danielrfry/opl2sd1/(threads)

Thread 1 (2022-04-13):

Publishing work on MIDI implementation?

nikitalita, 2022-04-13:
Hi,

there’s a thread on VOGONS where they discuss trying to implement MIDI on the MA-3 (aka the predecessor to the SD-1) and they mention they would love to see the SD-1 MIDI implementation published: https://www.vogons.org/viewtopic.php?p=1057380#p1057380

is this in the cards in the near future?

danielrfry, 2022-04-13:
Yes, I’m very keen to release the code as soon as it is in a generally usable state. The project includes several components (the names are placeholders):

- `libfmcore`: device-independent MIDI implementation in C++, with drivers for OPL2, OPL3, OPM and SD-1. Can be built as an RP2040 or Teensyduino library (possibly other Arduino targets too) for embedding, or linked into `libfm` for use on desktop/web platforms.
- `libfm`: library incorporating `libfmcore`, the DOSBox OPL emulator, and the MAME OPM emulator, targeting Linux, macOS and web (as a WASM module). Allows use of the MIDI implementation without dedicated hardware.
- `opl-patch-editor`: particularly badly named GUI patch editor and software synthesiser for OPL, OPM and SD-1. Implemented as a web app using React, `libfm`, web audio and web MIDI.
- `vgmtools`: collection of tools implemented in Python for converting, ‘disassembling’ and editing VGM/DRO files, converting MIDI to VGM, playing or rendering VGM/MID files to WAV, etc. using `libfm`.

Before releasing this, I’d like to:
- Rename everything. The placeholder names I picked are misleading and conflict with existing projects.
- Figure out licensing - either find a licence that is compatible with both the DOSBox/MAME emulator code in `libfm`, replace the emulators with equivalents with compatible licences, or extract the code into a separate project with a different licence.
- Implement MIDI device selection in the patch editor. Currently the MIDI input/output devices are automatically selected, with no easy way to override the selection if it is incorrect.
- Implement exporting patches as SYX files to make using custom patches in sequencers easier.

I hope to find the spare time to complete these last few pieces of work soon.

danielrfry, 2022-05-02:
An update for anyone interested: MIDI device selection is now implemented. I expect this to be the largest of these pieces of work.

I haven't made a final decision regarding licensing yet, but I expect to release `libfmcore` under the MIT Licence, and everything else under GPL v2. This is due to the use of the MAME YM2151 emulator, which uses this licence, in `libfm`. An alternative might be to replace it with the Nuked-OPM emulator, which is LGPL-licensed.

OPLx, 2022-05-06:
You may also want to take a look at [ymfm](https://github.com/aaronsgiles/ymfm) as well.

danielrfry, 2022-05-06:
@OPLx Ah, perfect - thanks for the tip! I've concluded that licensing for `libfm` doesn't matter too much, as it is essentially just glue code between the MIDI implementation and the emulators. But more of a concern is that using GPL'd code from Python or JS seems to count as 'linking' under the terms of that licence, which would affect `vgmtools` and the patch editor. So this sounds like an ideal solution to keep things flexible for those.

OPLx, 2022-05-07:
@danielrfry No problem.  Please keep up the great work!

danielrfry, 2022-05-10:
I've now replaced the DOSBox OPL and MAME OPM emulators with their equivalents from ymfm. Conveniently, this now means that all the code in libfm from other projects is BSD 3-clause-licensed.

libfm and vgmtools do not contain any code from other projects.

The patch editor, being an npm-based web app, has many dependencies - however, all use permissive licences that allow redistribution in source or compiled form. Certainly there is no (L)GPL'd code. So I think for simplicity, I will use BSD 3-clause for this too.

TLDR: Everything will be released under the BSD 3-clause licence.

danielrfry, 2022-05-17:
.SYX export is now implemented - so the largest remaining task is to rename all the projects. In addition, I have a few small issues to fix, and I'll try to write up some basic documentation as a starting point, then I should hopefully be ready to make the repositories public.

danielrfry, 2022-06-03:
As is often the way, the final small tasks multiplied... but I've now got to a point where I'm comfortable releasing everything, so the repositories are now public. I have named the project "Note Salad", in a move I may later regret.

https://github.com/danielrfry/notesalad/
https://github.com/danielrfry/notesalad-tools/
https://github.com/danielrfry/notesalad-editor/

I hope it can be of some use to someone!

Closed 2022-06-03.

Thread 2 (2023-03-25):

Stereo OPL2/OPL3 playback using two SD-1 modules

denjhang, 2023-03-25:
I've found that many OPL3 tracks have stereo, whereas the SD-1 is mono. So use two SD-1 combinations to achieve stereo.

danielrfry, 2023-04-06:
A few people have asked about this so I'm going to try.

One potential issue is that the YMF825Board has the clock oscillator integrated. My suspicion was that the two chips running with independent clocks may produce audio signals that are out-of-phase and create unintentional stereo separation where there should be none.

As a first test, I've connected both YMF825s to the same SPI bus, sharing the same CS and RST lines, so that in theory they receive the same signals simultaneously. I recorded a sample of music playback and subtracted one channel from another in Audacity, which should result in silence if the two chips are producing the same output; however, the tracks do indeed differ in phase and some higher frequencies are still audible in the combined channels. (Those sounds are also audibly separated when listening to the unmodified output).

It's possible that running the two chips from the same clock source would solve that, however I don't have the equipment or skills necessary to remove the YMF825 from the board, nor do I have a source of bare YMF825 chips to build into a new circuit.

It's an interesting experiment nonetheless so I will try updating the code to produce stereo output, and maybe someone with the capability and resources to build a dual-YMF825 circuit can make use of it.

denjhang, 2023-04-17:
I am capable of building dual YMF825 modules, I will draw the schematic, PCB and solder, I also have some YMF825 chips enough for testing. I can assist you with hardware testing.

denjhang, 2023-04-17:
In-phase clocks don't seem to solve this problem. Because it is rumored that the initial phase of Yamaha FM is random.

denjhang, 2023-04-17:
If you can provide interesting OPL3 VGM files like EndlessBreak, I'd like to hear that too.

danielrfry, 2023-04-18:
Yes, it's still an interesting experiment even if it's not possible to synchronise the two YMF825s perfectly.

I've pushed the stereo code, the builds are here: https://github.com/danielrfry/opl2sd1/actions/runs/4736826783
There are now two firmware images, one for mono and one for stereo operation.

If you'd like to try it, connect both YMF825 modules to the same SPI bus, with pin 6 → left channel YMF825 CS, pin 7 → right channel YMF825 CS.

(Please note I've changed the default pin assignments, so pin 6 is now used instead of pin 1 for CS in the mono firmware too. This is so that I can use pins 0 and 1 for debugging via UART. The documentation is not yet updated).

Endless Break by Pigu is on [Battle of the Bits](https://battleofthebits.org/arena/Entry/Endless+Break+%28short+ver.%29/30542/)!

danielrfry, 2023-04-19:
I think there may still be bugs in the channel allocator, so it might be possible to improve the performance further on 1 or 2 chips. I'd like to work some more on that when I have more time (I just needed a break from it for a little while!)

But if you'd like to build the 4 chip device anyway, I'd certainly like to see it and will be happy to update the code to support that. We can continue the discussion of that over on issue #7. Thanks!

Closed 2023-04-20.

Thread 5 (2023-04-08):

OPL drums are not audible.

denjhang, 2023-04-08:
When I listen to tracks like the YS II Special, the OPL2's own drums are barely audible.

danielrfry, 2023-04-08:
The OPL drum mode is not currently implemented as the SD-1 does not have an equivalent function. I was not aware of any soundtracks that used it - thank you for highlighting this one.

denjhang, 2023-04-08:
[Ys_II_Special_(IBM_PC_AT).zip](https://github.com/danielrfry/opl2sd1/files/11183453/Ys_II_Special_.IBM_PC_AT.zip)

denjhang, 2023-04-08:
I hope you can make similar drum sounds to replace the drum sounds that come with the OPL3. I can provide the relevant OPL3 parameters.

danielrfry, 2023-04-08:
> I can provide the relevant OPL3 parameters.
That would be very helpful, thank you.

denjhang, 2023-04-17:
`OPLL Instrument in OPL Format
-----------------------------
OPL Register Order
20 23 40 43 60 63 80 83 E0 E3 C0

Melody Instruments:
49 4C 4C 00 00 00 00 00 01 00 04	0 - User
61 61 1E 00 F0 78 00 17 01 00 0E	1 - Violin
13 41 1E 00 D7 F7 13 13 00 01 0A	2 - Guitar
13 01 99 00 F2 F4 11 23 00 00 08	3 - Piano
21 61 1B 00 AF 64 40 27 00 00 0E	4 - Flute
22 21 1E 00 F0 75 08 18 00 00 0C	5 - Clarinet
31 22 16 00 90 71 00 13 00 00 0A	6 - Oboe
21 61 1D 00 82 80 10 17 00 00 0E	7 - Trumpet
23 21 2D 00 C0 70 07 07 01 00 0C	8 - Organ
61 61 1B 00 64 65 10 17 00 00 0C	9 - Horn
61 61 0C 00 85 F0 70 07 01 01 00	A - Synthesizer
23 01 07 00 F0 A4 00 22 01 00 02	B - Harpsichord
97 C1 24 00 FF F8 22 12 00 00 0E	C - Vibraphone
61 10 0C 00 F2 F4 40 44 00 00 0A	D - Synth Bass
01 01 55 00 F3 92 F3 F3 00 00 06	E - Acoustic Bass
61 41 89 00 F1 F4 F0 13 00 00 06	F - Electric Bass

Drums:
01 01 16 00 FD F8 2F 6D 00 00 00	BD
01 01 00 00 D8 D8 F9 F8 00 00 00	HH / SD
05 01 00 00 F8 BA 49 55 00 00 00	TOM / TOP CYM`

denjhang, 2023-04-17:
I find it hard to get the HH/SD and TOM/TOP CYM sounds using conventional methods, because the four OPL drum sounds only use 1OP, and their waveforms are not necessarily sine waves.
Only BD can be obtained by conventional methods, the parameters are given:
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

denjhang, 2023-04-17:
https://www.smspower.org/maxim/Documents/YM2413ApplicationManual#v4
(V-4) Procedure of Percussion Sound Synthesis
Channels 7, 8 and 9 are used to synthesize percussion sounds. Five kinds of percussion sounds are generated by using these three channels and six slots. For the bass drum (BD), two slots are used to synthesize FM sounds. Therefore, bass drum sounds can be produced basically by the same procedure from (a) to (c). The other four kinds of percussion sounds (high hat, top cymbal, tom-tom, and snare drum) are described as follows.

OPLL includes a noise oscillator obtained by composing a white noise generator with several frequencies. This noise oscillator is specified by the frequency information (BLOCK, F-Number, Multiple) of the 8 and 9 channels. When composed with white noise, phase output suitable for percussion instruments is generated and given to the operator. Thus phases of four instruments are generated from two sets of frequency information. It is known empirically that the optimum ratio of two frequencies is 3:1 (f7CH = 3×f8CH). Now phase data of individual instruments are obtained. Next, we multiply this output with envelope information. Since the envelope is set as 1 slot -> 1 percussion instrument, values that reflect the characteristics of individual percussion instruments, as with melody instruments, are set in ROM. (Refer to [III-1-7](https://www.smspower.org/maxim/Documents/YM2413ApplicationManual#iii17))

denjhang, 2023-04-17:
So the built-in drum sound uses OPL's built-in noise generator, but the YMF825 doesn't have such a thing at all.

denjhang, 2023-04-17:
I'll come up with an approximation through lots of experimentation. Here is the Snare drum replacement:
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

denjhang, 2023-04-17:
BD seems to be a bit unsatisfactory, so I will try some more.

denjhang, 2023-04-18:
Here's the new BD, sounds okay
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

denjhang, 2023-04-20:
The latest experimental OPL drum sound, closer to the original sound.
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

denjhang, 2023-04-20:
[OPL Drum3.zip](https://github.com/danielrfry/opl2sd1/files/11279490/OPL.Drum3.zip)
I uploaded the wopl, you can experiment and quote as you like.

denjhang, 2023-04-20:
Many friends are interested in this function, I suggest you try to update the OPL drum. Once this feature is perfected, all OPL2 tracks will play perfectly. (However, when OPL3 uses its own drum channel, the total number of channels will be 15+5=20)

Thread 6 (2023-04-08):

Playing VGM with OPL3 dynamic channel allocation is very stuck

denjhang, 2023-04-08:
This is very strange.

denjhang, 2023-04-08:
[Invention and Sinfonia.zip](https://github.com/danielrfry/opl2sd1/files/11183010/Invention.and.Sinfonia.zip)

danielrfry, 2023-04-08:
Yes, the channel allocator is very simplistic currently; I implemented just enough for tracker tunes and OPL2 soundtracks that use the same set of channels repeatedly - it does not work well for MIDI for example, if many OPL channels are used in sequence. I hope to improve this soon.

danielrfry, 2023-04-10:
Audio files demonstrating the issue, for comparison:
[OPL2SD1_Issue_6.zip](https://github.com/danielrfry/opl2sd1/files/11190021/OPL2SD1_Issue_6.zip)

OPL3 version rendered using ymfm via `nsplay` from [Note Salad Tools](https://github.com/danielrfry/notesalad-tools)
YMF825 version played back using opl2sd1 firmware and RetroWave_Player on macOS

denjhang, 2023-04-10:
The problem seems to be solved, so how do I play my VGM?

danielrfry, 2023-04-10:
I haven't made any changes to the channel allocator yet. There are notes being cut off in the YMF825 version I posted above - were you experiencing a different issue?

I did not test the Python VGM player on Windows as I don't often use that OS, so there may be some platform-specific issues as well.

The latest opl2sd1 revision implements the RetroWave OPL3 serial protocol, so you could try the latest firmware version and the [RetroWave_Player](https://github.com/SudoMaker/RetroWave) tool to play VGM files.

denjhang, 2023-04-10:
It looks like I have to recompile the firmware.
It seems that using the Pico SDK on Windows 10 is a bit complicated, can you just upload the latest UF2 firmware so I can test it quickly?

danielrfry, 2023-04-10:
I've added automated builds with GitHub Actions, you can find the UF2 for the current revision here:

https://github.com/danielrfry/opl2sd1/actions/runs/4657279593

denjhang, 2023-04-10:
I have updated the firmware, but how to use nsplay? I found that when I use Retro Wave Player directly, the notes are still cut off.
And the compatibility of Retro Wave Player to VGM is poor, when encountering non-OPL3 music, Retro Wave Player will not skip automatically and the program will close automatically. When playing Invention.and.Sinfonia.zip, only 5 tracks can be played continuously, and then the program will close automatically.
So I suggest you keep the Python player you wrote for stronger compatibility.

danielrfry, 2023-04-10:
The audio files were just to demonstrate the correct/incorrect sound, to help with identifying/fixing the issue - I haven't made any changes to the allocator code yet.

The OPL3 version is rendered using `nsplay` and the `ymfm` emulator, and demonstrates the correct sound.
The YMF825 version is recorded output from the current firmware, which has the channel allocation issues.

My aim is to add RetroWave protocol support to `nsplay` (which has more features than the sample Python VGM player in this repository) so that it can be used with this device, the RetroWave OPL3 board, and the `ymfm` emulator. That way there will be no need to maintain two separate player programs, and any VGM player compatible with RetroWave can also be used.

danielrfry, 2023-04-10:
I have re-written the channel allocator which I believe will resolve some of the issues described here and in #13.

Please try the latest firmware build from here:
https://github.com/danielrfry/opl2sd1/actions/runs/4659405073

denjhang, 2023-04-11:
Although the latest firmware has alleviated the problem of note stuttering, it is not perfect, and many sustains and chords will still be "swallowed".

denjhang, 2023-04-11:
You can test my music and sound bank with the latest version of OPL3BankEditor
[Coup De Coeur.zip](https://github.com/danielrfry/opl2sd1/files/11195738/Coup.De.Coeur.zip)

denjhang, 2023-04-11:
Regarding the channel allocation algorithm, I suggest that you can also refer to the method of OPL3BankEditor, because I run this program directly on the computer and it will play my music perfectly.

denjhang, 2023-04-11:
It is obvious that YMF825 lacks more than 2 channels than OPL3. When the channels are obviously insufficient, my suggestion is to give higher priority to the shorter notes, let them cover the longer notes, and let the notes that appear later cover the earliest notes. The notes that appear.

denjhang, 2023-04-11:
Because in many piano MIDIs, there are many overlong sustained tones, which are usually caused by the sustain pedal or reverberation. Once it lasts for 1S, this note will have no meaning, so these notes can be covered.

danielrfry, 2023-04-12:
I have fixed some bugs that were causing notes to be cut off when they should not have been, if you'd like to try the latest build:

https://github.com/danielrfry/opl2sd1/actions/runs/4683260124

I'm hopeful this version will handle sustained notes much better.

denjhang, 2023-04-13:
Today I tried the piano solo midi music without sustain, and found that it is normal when using 2op tones, but when I use 2x2op tones, the sound swallowing phenomenon still occurs.
For midi piano solos that use a lot of extended sounds, the current version of the firmware still swallows the sound seriously.
[Yiruma-SOLO.zip](https://github.com/danielrfry/opl2sd1/files/11224313/Yiruma-SOLO.zip)
Here's a set of solo midi pianos that make heavy use of the sustain pedal.

danielrfry, 2023-04-15:
I think there might be more than one issue here - I've fixed a couple more things but I'm not sure whether they are related to the problem you've described. I have found it quite difficult to debug with such complex MIDI files.

https://github.com/danielrfry/opl2sd1/actions/runs/4708450511/jobs/8350896014

Please could you find a single, simple example of the problem, and provide detailed steps to recreate it (including the exact bank file and instrument to use in OPL3BankEditor). If you could provide short recordings showing an example of the correct/incorrect playback as well, that would help me to understand the issue better. Thanks!

denjhang, 2023-04-15:
The latest version of the firmware has improved significantly. Sincerely happy for you.

denjhang, 2023-04-15:
https://user-images.githubusercontent.com/61811583/232237607-3710a828-a588-47ff-adfb-d3d51a026478.mp4
https://user-images.githubusercontent.com/61811583/232237615-5de20298-be54-4d92-803c-75f51be8126d.mp4
These two videos show the correct sound, too beautiful piano music (at least I think so). By the way, this is my completely original OPL3 piano sound, only using FM parameters to realize the reverb effect, without relying on any external DSP reverb.
Below are the midi files and library files played in the video. I use "Warm Grand Piano", Bank 0, ID 7.
[Lost In Island.zip](https://github.com/danielrfry/opl2sd1/files/11239995/Lost.In.Island.zip)

denjhang, 2023-04-16:
I've found that it probably takes more than 2 SD-1 modules to play the music perfectly. At present, it does not seem to be a problem with the scheduling algorithm, and it is very likely that there are still insufficient channels when it is optimized to the extreme.

denjhang, 2023-04-16:
Most solo midi piano music that doesn't make extensive use of the sustain pedal can now be played normally.

denjhang, 2023-04-16:
On the other hand, even when I play Lost In Island.zip with 2op patches, there are still a lot of notes being cut off and swallowed.

Thread 7 (2023-04-08):

Support 4 or more SD-1 modules to play full OPL3 stereo or dual-chip music.

denjhang, 2023-04-08:
Because Pico has enough IO ports, you can consider it.

denjhang, 2023-04-19:
I'm going to make a new version of the schematic diagram and PCB, and I plan to do advanced design. I feel that to play all OPL3 tracks perfectly, four chips are needed, because some tracks use all 18 channels at the same time, and the channels are still not enough. No matter how you schedule it . So I'm going to add 4 SD-1 module designs that don't currently exist. I hope you can make pin 8, 9 (or even more) as chip select for the third and fourth YMF825.
In other words, the current chip selection situation is as follows:
pin6->CS_L
pin7->CS_R
pin8->CS_L2
pin9->CS_R2

danielrfry, 2023-04-20:
Amazing! I will get to work on the 4-chip code ASAP 😄

danielrfry, 2023-04-20:
I've been using the UART on pins 0 and 1 for real-time logging, so it might be useful if that could be brought out somewhere 👍

danielrfry, 2023-04-22:
The latest build here can drive four YMF825 chips:
https://github.com/danielrfry/opl2sd1/actions/runs/4774752669

(It's the dual-stereo firmware version).

I only have two YMF825 boards, so I haven't been able to test this fully - but I have been able to connect two at a time, make two recordings and mix them and it sounds OK.

denjhang, 2023-04-26:
I've done my 4xYMF825 hardware, but I'm finding that the stereo effect is not noticeable.I wanted the stereo effect to be stronger, which meant that the music played by the two chips needed to be distinctly different.
On the other hand, I found that the OPL drum sound is still not audible, I think you should fix it.

danielrfry, 2023-04-26:
The stereo effect should be the same as that of the OPL3, and I've found that to be true in my testing. Were you expecting it to add stereo separation to mono sounds? (It does this a little, but not intentionally, due to the phase differences we've discussed elsewhere!)

I've started work on implementing the OPL drum mode - just a reminder though, I work on this in my limited spare time, so things may sometimes progress slowly.

denjhang, 2023-04-27:
What I really mean is that currently the OPL2SD1 uses 4 YMF825 modules to play stereo OPL3 VGM, the stereo effect is not obvious, not stereo is required to play mono tracks.
Such as Moondriver Demo
[MoonDriver Demo.zip](https://github.com/danielrfry/opl2sd1/files/11343076/MoonDriver.Demo.zip)

By the way, in the current situation, it is also possible to play mono VGM in stereo, but this is not the most important thing. My opinion is to manually specify whether each channel is left or right or center for mono tracks.

denjhang, 2023-04-27:
I found that when I use 4xYMF825 and use OPL3BankEditor, the sound from CS_L and CS_R is only on the left side, and the sound from CS_L2 and CS_R2 is only on the right side, which is very strange, I suspect you messed up the CS wire, I still use Connect in the following way:
pin6->CS_L
pin7->CS_R
pin8->CS_L2
pin9->CS_R2

denjhang, 2023-04-27:
I found that when I use firmware-uf2-stereo, the stereo effect is good, but with firmware-uf2-dual-stereo the stereo effect is not obvious.

denjhang, 2023-04-27:
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

denjhang, 2023-04-27:
After upgrading the firmware, the dual-stereo effect is also very good. I found that your previous concerns about the phase of the crystal oscillator are unnecessary.

Thread 12 (2023-04-10):

Support Arduino OPL2 (OPL3) communication protocol.

denjhang, 2023-04-10:
If it can support this, then I can easily use OPL3BankEditor to debug the YMF825 sound.
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

denjhang, 2023-04-10:
https://github.com/DhrBaksteen/ArduinoOPL2

danielrfry, 2023-04-10:
Current development builds of OPL3BankEditor support the RetroWave OPL3 protocol, so it can already be used with `opl2sd1`.

Closed 2023-04-10.

Thread 13 (2023-04-10):

Notes could not be assigned correctly using OPL3BankEditor

denjhang, 2023-04-10:
I tried the latest OPL3BankEditor and found that most of the notes are cut off. It seems that only monophonic music will work normally. Once there are chords, the notes will be cut off. There seems to be a serious problem with the channel allocation algorithm at the moment.

denjhang, 2023-04-10:
[Piano.zip](https://github.com/danielrfry/opl2sd1/files/11190845/Piano.zip)

Thread 20 (2023-04-27):

Assign separate pins for visualization led lights.

denjhang, 2023-04-27:
Currently I'm connecting the CS wire directly to the LED light, but this creates noise, so I'd like to use other pins to drive the LED light independently to visualize the CS signal.
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

danielrfry, 2023-04-30:
I've added this to help you test your hardware, but I'd prefer not to merge it into the main branch of this project, as I'd like to keep it independent of any specific hardware (apart from the test circuit included in the repository).

The pins used are:
- CS_L: 10
- CS_R: 11
- CS_L2: 12
- CS_R2: 13

...and are active low like the SD-1 CS pins.

I'm surprised that connecting LEDs to the CS pins creates noise - I would expect there to be very little current flowing into the SD-1 via that route. Are the LED and SD-1 ground paths separated?

denjhang, 2023-04-30:
The way I use CS to drive LED is very simple, you see this schematic:
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
Of course, if you have a better way (such as using a transistor to drive an LED), then I'm willing to modify that as well.

danielrfry, 2023-04-30:
Ah, I have only the most basic knowledge of electronics! I've fixed similar noise issues in my projects by ensuring sensitive components have physically separate paths to ground. But I guess that is not applicable in this case because the GPIO pin is the current sink.
