danielrfry/opl2sd1/(list of files, drawings)

Other design files:
hardware/OPLSD1.fzz
