danielrfry/opl2sd1/firmware/src/config.h

#pragma once

#include "SD1ArrayConfiguration.h"

#if !defined(OPL2SD1_DUAL_STEREO)
#define OPL2SD1_DUAL_STEREO 0
#endif

#if !defined(OPL2SD1_STEREO)
#define OPL2SD1_STEREO 0
#endif

#define PIN_SCK 2
#define PIN_MOSI 3
#define PIN_RST 4
#define PIN_OE 5

// If stereo is not enabled, only PIN_CS_L is used
#define PIN_CS_L 6
#define PIN_CS_R 7

// These pins are only used when dual stereo is enabled
#define PIN_CS_L2 8
#define PIN_CS_R2 9

#define PIN_LED_CS_L 10
#define PIN_LED_CS_R 11
#define PIN_LED_CS_L2 12
#define PIN_LED_CS_R2 13

extern const SD1ArrayConfiguration SD1_ARRAY_CONFIG;
