danielrfry/opl2sd1/firmware/src/SD1DeviceArray.h

#pragma once

#include "SD1ArrayConfiguration.h"
#include <cstdint>

class SD1DeviceArray {
public:
    const SD1ArrayConfiguration* config;
    SD1DeviceArray(const SD1ArrayConfiguration* config);
    void init();
    void reset();
    void write(const uint8_t* data, const uint16_t len, int8_t bank = -1, SD1Channel channel = SD1Channel::ALL);
    void writeReg(uint8_t addr, uint8_t data, int8_t bank = -1, SD1Channel channel = SD1Channel::ALL);
};
