danielrfry/opl2sd1/(commit log)

2021-10-29 Add hardware docs and README.
    [OPLSD1.fzz]
2023-04-02 Track CS state.
2023-04-08 Enable output to two SD-1 devices simultaneously.
2023-04-10 Check out Pico SDK submodules.
2023-04-10 Key off/reset envelope when deallocating SD-1 voice.
    [SD1OPLAdaptor.cpp, SD1OPLAdaptor.h]
2023-04-10 Add initial OPL translator reset.
    [SD1OPLAdaptor.cpp, main.cpp]
2023-04-11 Fix voice allocator bugs.
    [SD1OPLAdaptor.cpp, VoiceAllocator.cpp, VoiceQueue.h]
2023-04-12 More voice allocation bug fixes.
    [SD1OPLAdaptor.cpp, VoiceAllocator.cpp]
2023-04-14 Reset envelope generator when re-assigning voices.
    [SD1OPLAdaptor.cpp]
2023-04-15 Fix 4-op connection mode mapping.
    [SD1Utils.cpp]
2023-04-16 Initial support for stereo using two SD-1 devices.
2023-04-20 Update schematic & breadboard for new default pin assignments.
    [OPLSD1.fzz]
2023-04-21 Add device array and config classes for generalised multi-chip support.
2023-04-21 Add number of banks to device array configuration.
2023-04-21 Add SD-1 device bank selection.
2023-04-22 Extract pitch update function.
2023-04-22 Select appropriate voice allocator for device configuration.
2023-04-22 Add dual stereo device configuration & fix bugs.
    [SD1OPLAdaptor.cpp, config.cpp, config.h]
2023-04-27 Fix bug causing mono output in dual-stereo configuration.
    [SD1OPLAdaptor.cpp]
